mihaigalos/DotControl/hardware/DotControl.brd

## EAGLE design hardware/DotControl.brd (2017-12-18)

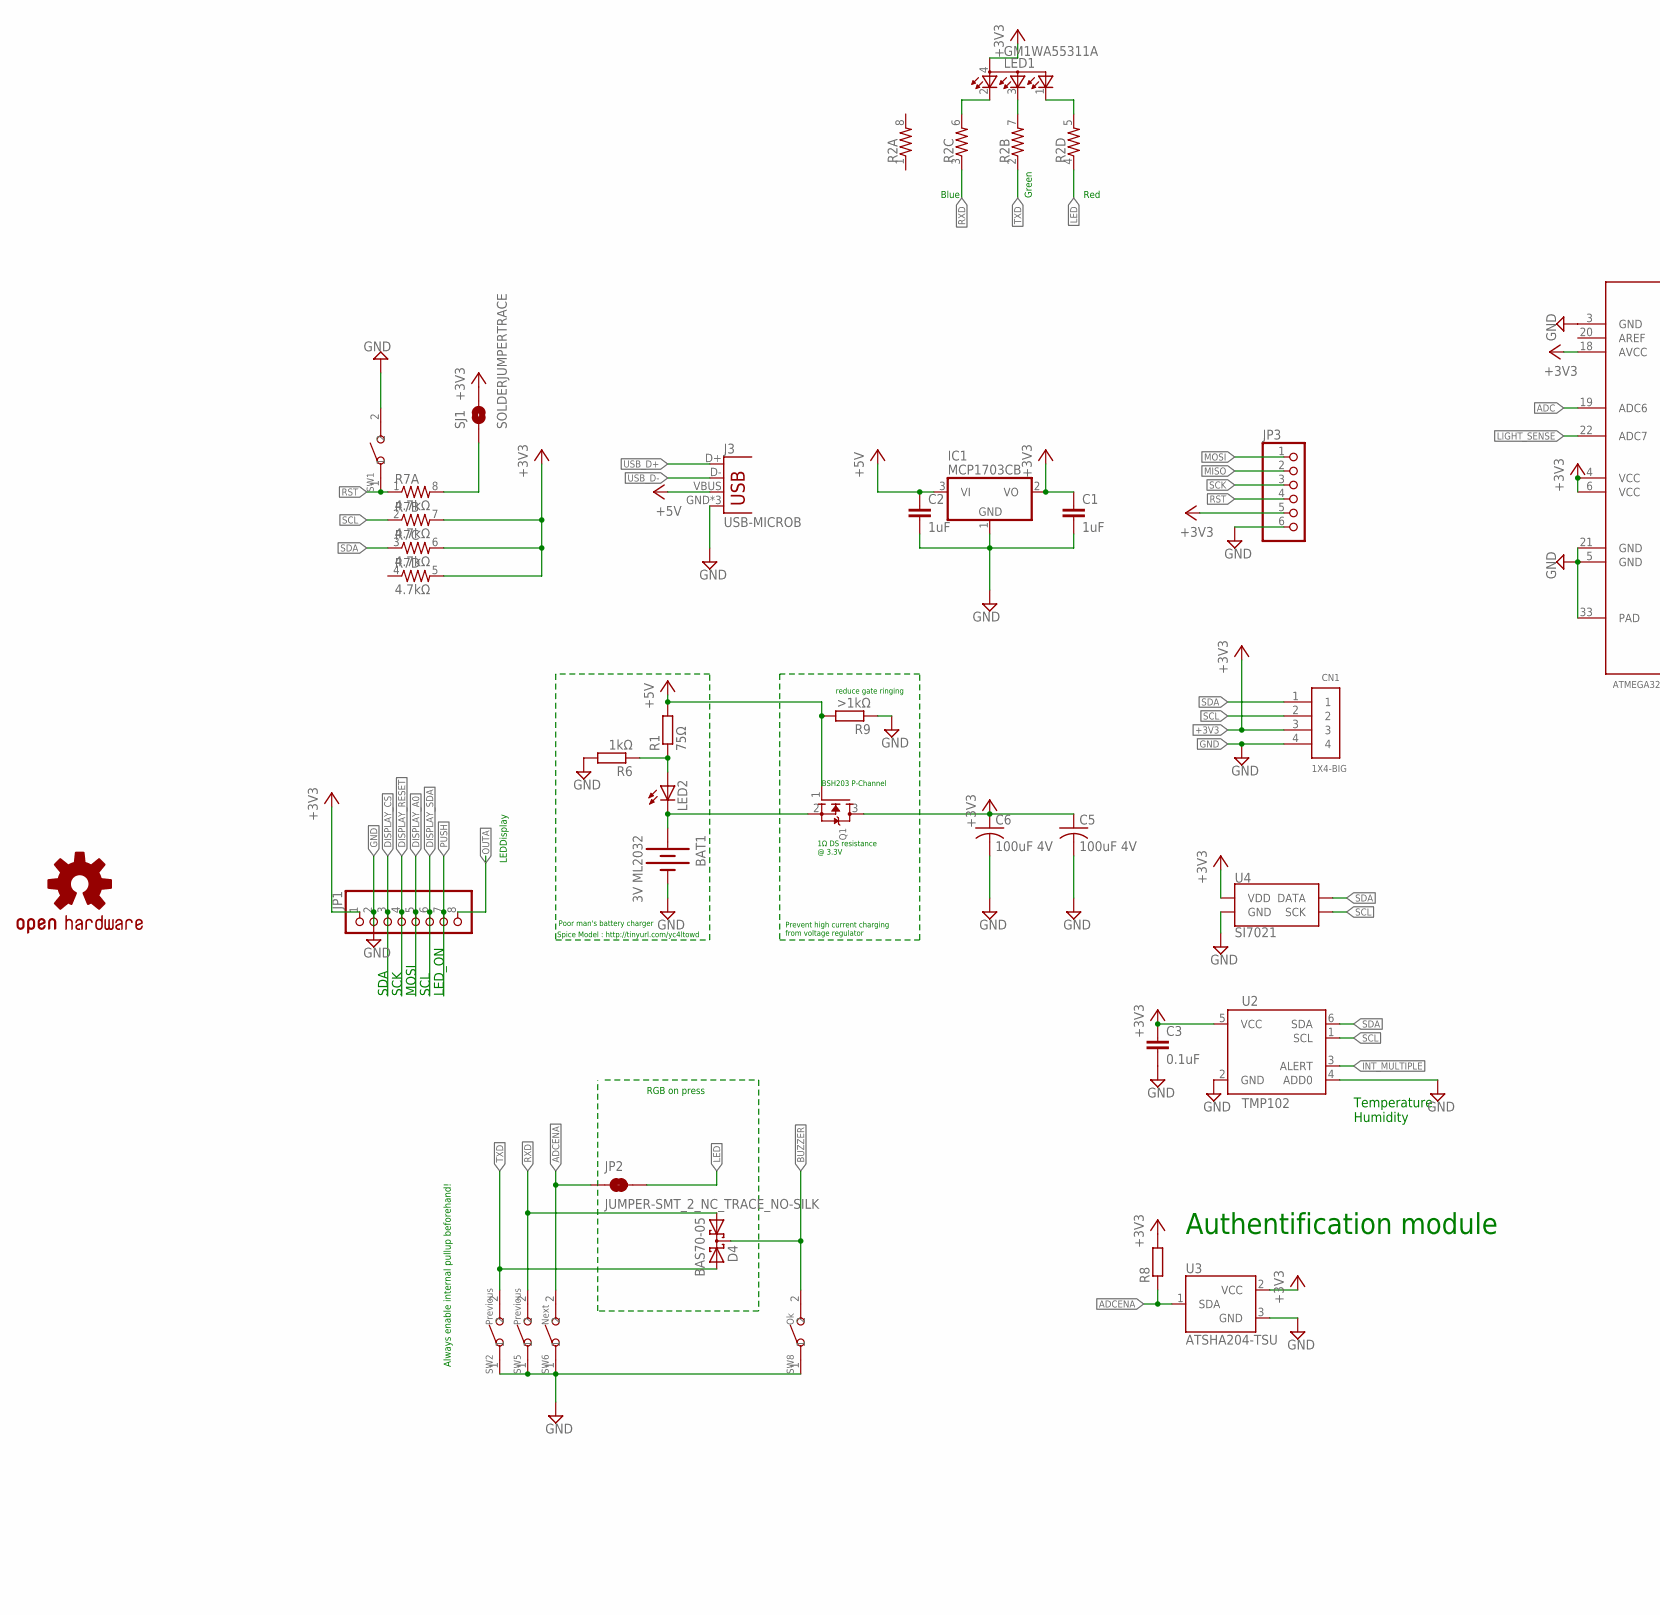
[picture p1: schematic DotControl.sch, sheet 1, part in row 1, column 1]

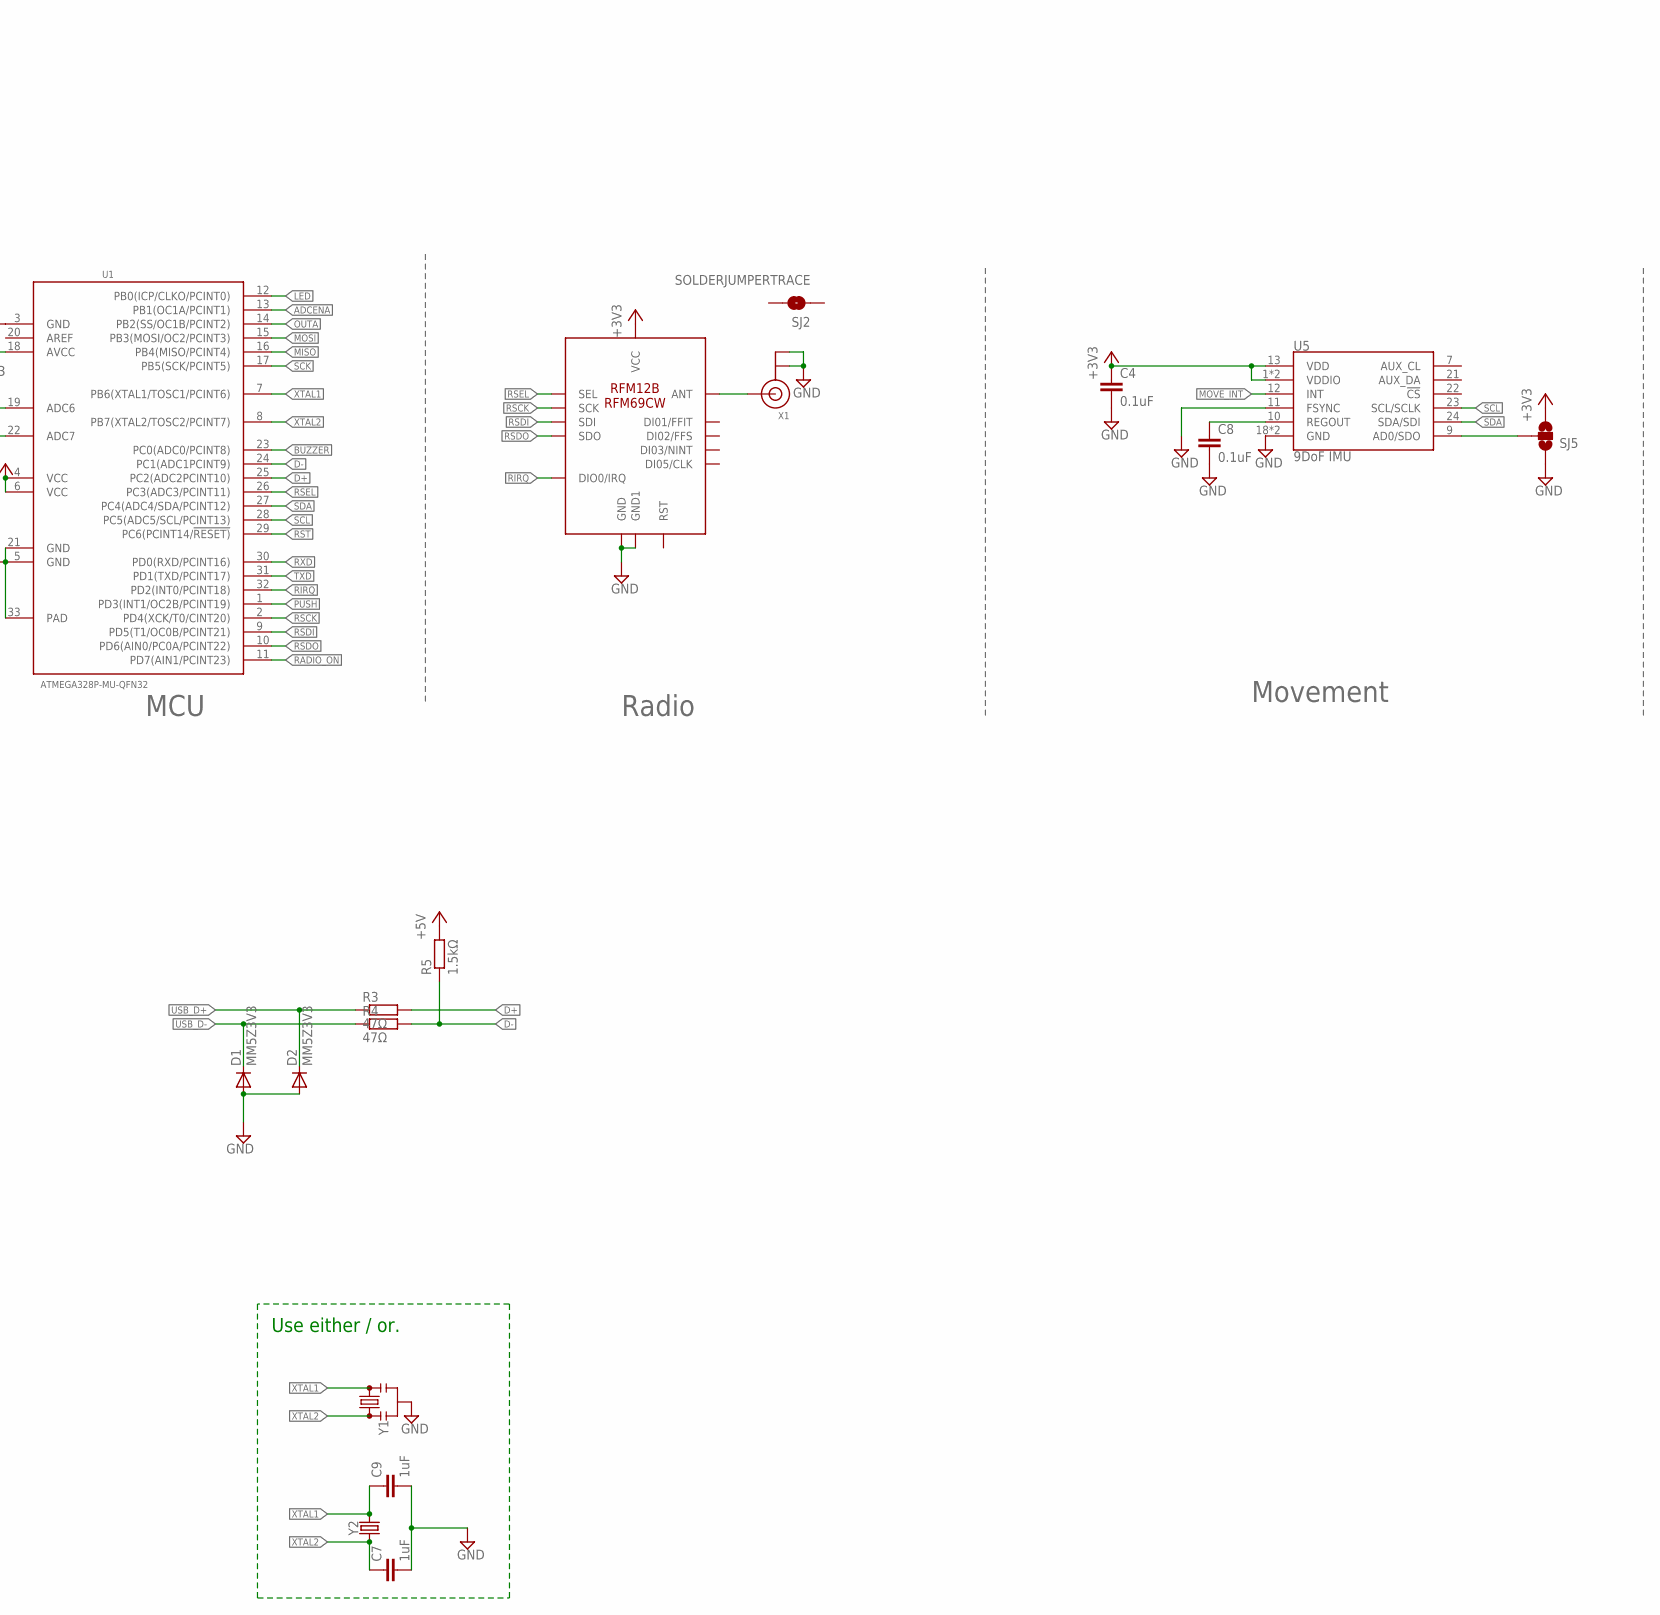
[picture p2: schematic DotControl.sch, sheet 1, part in row 1, column 2]

Parts:
BAT1: 3V ML2032; BATTCOM_20MM_PTH
C1, C2, C7, C9: 1uF; C0603
C3, C4, C8: 0.1uF; C0603
C5, C6: 100uF 4V; C3216
CN1: 1X4-BIG; 1X04-BIG
D1, D2: MM5Z3V3; SOD523
D4: BAS70-05; SOT23
IC1: MCP1703CB; SOT23
J3: USB-MICROB
JP1: PINHD-1X8CLEANBIG; 1X08-CLEANBIG
JP2: JUMPER-SMT_2_NC_TRACE_NO-SILK; SMT-JUMPER_2_NC_TRACE_NO-SILK
JP3: PINHD-1X6; 1X06
LED1: GM1WA55311A
LED2: LED0603; LED-0603
Q1: MOSFET-NREFLOW; SOT23
R1: 75Ω; R0603
R2: RESISTOR-ARRAY0603-ARV; 0603-ARV
R3, R4: 47Ω; R0603
R5: 1.5kΩ; R0603
R6: 1kΩ; R0603
R7: 4.7kΩ; 0603-ARV
R8: R-EU_R0603; R0603
R9: >1kΩ; R0603
SJ1, SJ2: SOLDERJUMPERTRACE; SJ_2S-TRACE
SJ5: SOLDERJUMPER_2WAYS; SJ_3
SW1: SMD-BUTTON(2P-6.0X3.0X2.5MM)-DHT-1163S; SW2-4.0-6.0X3.0X2.5MM
SW2, SW5: Previous; SW2-4.0-6.0X3.0X2.5MM
SW6: Next; SW2-4.0-6.0X3.0X2.5MM
SW8: Ok; SW2-4.0-6.0X3.0X2.5MM
U1: ATMEGA328P-MU-QFN32; QFN32G-0.5-5X5MM
U2: TMP102; SOT563
U3: ATSHA204-TSU; SOT23-3
U4: SI7021; DFN-6-3X3-SI7021
U5: 9DoF IMU; QFN24-3X3
U$1: RFM12B/69CW
U$2: OSHW-LOGOL; OSHW-LOGO-L
X1: ANTENNA_U.FL; U.FL
Y1: RESONATORSMD-3.2X1.3; RESONATOR-SMD-3.2X1.3
Y2: CRYSTALSMD-3.2X1.5; CRYSTAL-SMD-3.2X1.5MM

Connections:
+3V3: C1.1, C3.1, C4.1, C5.1, C6.1, CN1.3, IC1.2 (VO), JP1.1, JP3.5, LED1.4 (A), Q1.3 (D), R7.5 (2), R7.6 (2), R7.7 (2), R8.2, SJ1.2, SJ5.3, U1.4 (VCC), U1.6 (VCC), U1.18 (AVCC), U2.5 (VCC), U3.2 (VCC), U4.VDD, U5.1 (VDDIO), U5.8 (VDDIO), U5.13 (VDD), U$1.VDD (VCC)
+5V: C2.1, IC1.3 (VI), J3.VBUS, Q1.1 (G), R1.2, R5.2, R9.2
ADC: U1.19 (ADC6)
ADCENA: JP2.1, R8.1, SW6.2, U1.13 (PB1(OC1A/PCINT1)), U3.1 (SDA)
BLUE: LED1.2 (CRED), R2.6 (2)
BUZZER: D4.3 (C), SW8.2, U1.23 (PC0(ADC0/PCINT8))
D+: R3.2, U1.25 (PC2(ADC2PCINT10))
D-: R4.2, R5.1, U1.24 (PC1(ADC1PCINT9))
DISPLAY_A0: JP1.5
DISPLAY_CS: JP1.3
DISPLAY_RESET: JP1.4
DISPLAY_SDA: JP1.6
GND: BAT1.2 (-), C1.2, C2.2, C3.2, C4.2, C5.2, C6.2, C7.2, C8.2, C9.2, CN1.4, D1.A, D2.A, IC1.1 (GND), J3.GND, J3.MT1 (GND), J3.MT2 (GND), JP1.2, JP3.6, R6.2, R9.1, SJ5.1, SW1.2, SW2.1, SW5.1, SW6.1, SW8.1, U1.3 (GND), U1.5 (GND), U1.21 (GND), U1.33 (PAD), U2.2 (GND), U2.4 (ADD0), U3.3 (GND), U4.GND, U5.11 (FSYNC), U5.18 (GND), U5.20 (GND), U$1.GND, U$1.GND1, X1.1 (GND), X1.2 (GND), Y1.2
GREEN: LED1.3 (CBLUE), R2.7 (2)
INT_MULTIPLE: U2.3 (ALERT)
LED: JP2.2, R2.4 (1), U1.12 (PB0(ICP/CLKO/PCINT0))
LIGHT_SENSE: U1.22 (ADC7)
MISO: JP3.2, U1.16 (PB4(MISO/PCINT4))
MOSI: JP3.1, U1.15 (PB3(MOSI/OC2/PCINT3))
MOVE_INT: U5.12 (INT)
unnamed: LED2.A, R1.1, R6.1
unnamed: R7.8 (2), SJ1.1
unnamed: U$1.ANT, X1.3 (SIGNAL)
unnamed: SJ5.2, U5.9 (AD0/SDO)
unnamed: C8.1, U5.10 (REGOUT)
unnamed: BAT1.1 (+), LED2.C, Q1.2 (S)
OUTA: JP1.8, U1.14 (PB2(SS/OC1B/PCINT2))
PUSH: JP1.7, U1.1 (PD3(INT1/OC2B/PCINT19))
RADIO_ON: U1.11 (PD7(AIN1/PCINT23))
RED: LED1.1 (CGREEN), R2.5 (2)
RIRQ: U1.32 (PD2(INT0/PCINT18)), U$1.IRQ (DIO0/IRQ)
RSCK: U1.2 (PD4(XCK/T0/CINT20)), U$1.SCK
RSDI: U1.9 (PD5(T1/OC0B/PCINT21)), U$1.SDI
RSDO: U1.10 (PD6(AIN0/PC0A/PCINT22)), U$1.SDO
RSEL: U1.26 (PC3(ADC3/PCINT11)), U$1.SEL
RST: JP3.4, R7.1, SW1.1, U1.29 (PC6(PCINT14/!RESET))
RXD: D4.1 (A1), R2.3 (1), SW5.2, U1.30 (PD0(RXD/PCINT16))
SCK: JP3.3, U1.17 (PB5(SCK/PCINT5))
SCL: CN1.2, R7.2 (1), U1.28 (PC5(ADC5/SCL/PCINT13)), U2.1 (SCL), U4.SCK, U5.23 (SCL/SCLK)
SDA: CN1.1, R7.3 (1), U1.27 (PC4(ADC4/SDA/PCINT12)), U2.6 (SDA), U4.DATA, U5.24 (SDA/SDI)
TXD: D4.2 (A2), R2.2 (1), SW2.2, U1.31 (PD1(TXD/PCINT17))
USB_D+: D2.C, J3.D+, R3.1
USB_D-: D1.C, J3.D-, R4.1
XTAL1: C9.1, U1.7 (PB6(XTAL1/TOSC1/PCINT6)), Y1.3, Y2.P$2 (2)
XTAL2: C7.1, U1.8 (PB7(XTAL2/TOSC2/PCINT7)), Y1.1, Y2.P$1 (1)

Notes on the sheet:
MCU
Radio
Blue
Green
Red
Always enable internal pullup beforehand!
Temperature Humidity
MOSI
SCK
SDA
SCL
LED_ON
LEDDisplay
Authentification module
RGB on press
Movement
Spice Model : http://tinyurl.com/yc4ltowd
BSH203 P-Channel
Poor man's battery charger
Prevent high current charging from voltage regulator
reduce gate ringing
1Ω DS resistance @ 3.3V
Use either / or.

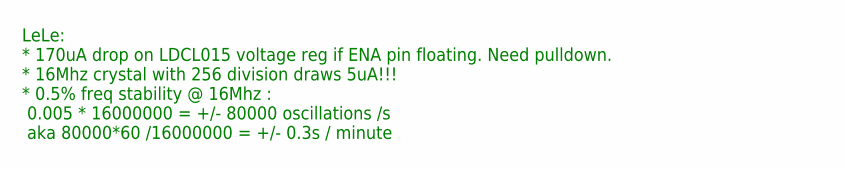
[picture p3: schematic DotControl.sch, sheet 2]

Notes on the sheet:
LeLe: * 170uA drop on LDCL015 voltage reg if ENA pin floating. Need pulldown. * 16Mhz crystal with 256 division draws 5uA!!! * 0.5% freq stability @ 16Mhz : 0.005 * 16000000 = +/- 80000 oscillations /s aka 80000*60 /16000000 = +/- 0.3s / minute

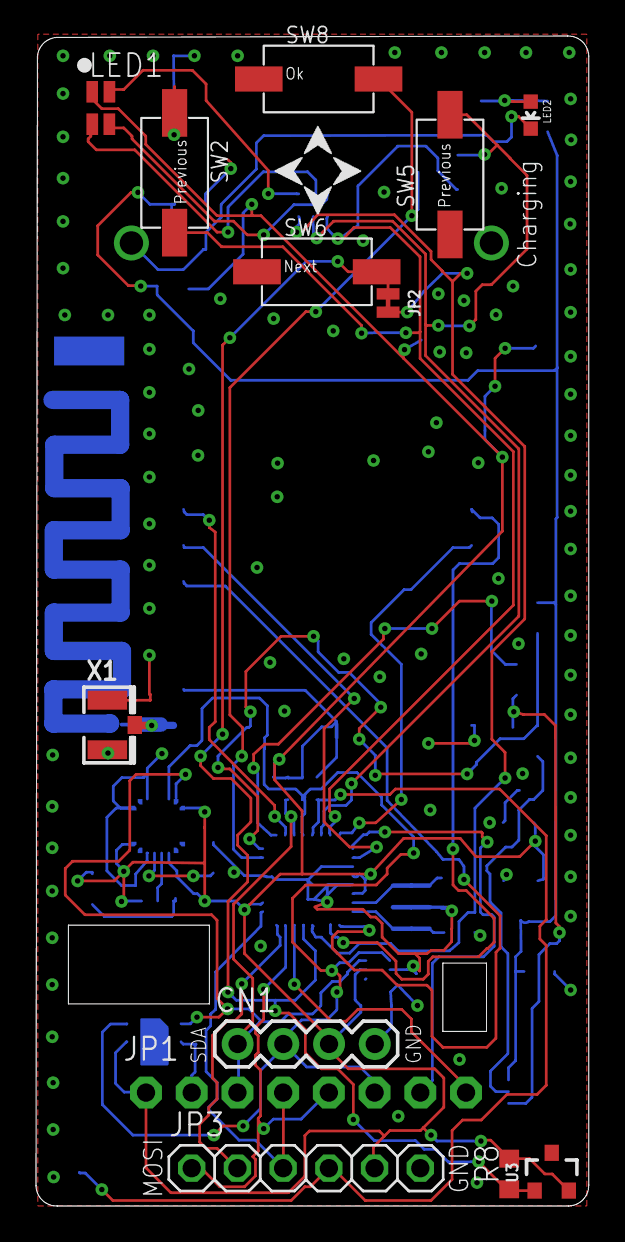
[picture p4: board DotControl.brd from above]

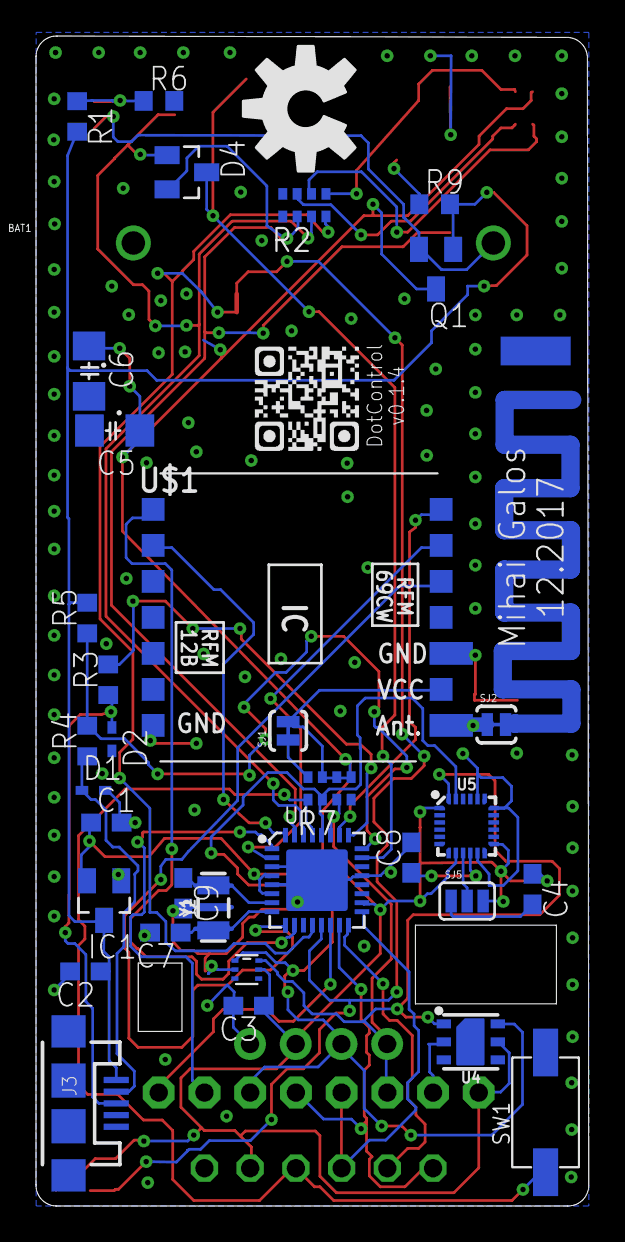
[picture p5: board DotControl.brd from below]

Board: 2 copper layers, 30.7 x 65.0 mm, 49 parts (36 on the bottom side), 36 nets.
