mihaigalos/DotControl/(commit log)

2017-10-31 Initial version
    [DotControl.brd, DotControl.sch]
2017-10-31 Add RGB and crystal
    [DotControl.brd, DotControl.sch]
2017-10-31 Add strong GND plane
    [DotControl.brd]
2017-10-31 Add charging led
    [DotControl.brd, DotControl.sch]
2017-10-31 Add TMP112 temperature sensor
    [DotControl.brd, DotControl.sch]
2017-11-02 Solidify GND plane
    [DotControl.brd]
2017-11-02 Add connections for 128x128
    [DotControl.brd, DotControl.sch]
2017-11-02 Add hardware/ and .gitignore
    [DotControl.brd, DotControl.sch]
2017-11-02 Add QR and timestamp
    [DotControl.brd]
2017-11-03 Update QR rotation
    [DotControl.brd]
2017-11-03 Update display supply to 3.3V, charging of battery
    [DotControl.brd, DotControl.sch]
2017-11-03 Rotate temp sensor
    [DotControl.brd]
2017-11-03 Update version to v0.1.1
    [DotControl.brd]
2017-11-03 Minor rearrange wires
    [DotControl.brd]
2017-11-03 Improve routing and vias
    [DotControl.brd]
2017-11-03 Add rounded corners
    [DotControl.brd]
2017-11-05 Add CryptoAuthentication module
    [DotControl.brd, DotControl.sch]
2017-11-05 Reposition crypto module
    [DotControl.brd]
2017-11-18 Add key to RGB
    [DotControl.brd]
2017-11-18 Add PCB antenna
    [DotControl.brd, DotControl.sch]
2017-11-18 Increase clearance of antenna
    [DotControl.brd]
2017-11-18 Add missing 3V3 connection to battery
    [DotControl.brd, DotControl.sch]
2017-11-18 Improve GND
    [DotControl.brd]
2017-11-18 Edit ToDos
    [DotControl.brd]
2017-11-19 Add HW support for USB bootloading
    [DotControl.brd, DotControl.sch]
2017-11-19 Reassign push buttons
    [DotControl.brd, DotControl.sch]
2017-11-19 Setting vias near rgb R-array further apart
    [DotControl.brd, DotControl.sch]
2017-11-19 Swap R with B @ pushbutton
    [DotControl.brd, DotControl.sch]
2017-11-19 Light RGB composite colors on push press
    [DotControl.brd, DotControl.sch]
2017-11-19 Add Si7021 temp sensor
    [DotControl.brd, DotControl.sch]
2017-11-19 Add I2C text
    [DotControl.brd]
2017-11-20 [Beta] Add HW support for MPU9250
    [DotControl.brd, DotControl.sch]
2017-11-22 Add caps for MPU9250, V divider for battery charge
    [DotControl.brd, DotControl.sch]
2017-11-22 Tidy up logos of Rs
    [DotControl.brd]
2017-11-22 Readjust R values for charger, add Spice link
    [DotControl.brd, DotControl.sch]
2017-11-25 Add pulldown on ENA pin of voltage reg to prefent 150uA quiescent current
    [DotControl.brd, DotControl.sch]
2017-11-25 Add pulldown on ENA pin of voltage reg to prevent 150uA quiescent current
    [DotControl.sch]
2017-11-25 [Intermediate] Improve coincell charging
    [DotControl.brd, DotControl.sch]
2017-11-26 Replace LDO with low quiescence regulator
    [DotControl.brd, DotControl.sch]
2017-11-26 Clean warnings
    [DotControl.brd, DotControl.sch]
2017-11-26 Improve GND, increase version
    [DotControl.brd]
2017-11-26 2x100uF instead of 1x1000uF
    [DotControl.brd, DotControl.sch]
2017-11-26 Update LeLe: 16Mhz with 256 divider = 5uA draw
    [DotControl.brd, DotControl.sch]
2017-11-26 Update LeLe: +/-0.3s / minute drift @ 16Mhz
    [DotControl.sch]
2017-11-30 Add support for 10ppm crystal
    [DotControl.brd, DotControl.sch]
2017-12-06 Add missing pullup to crypto chip
    [DotControl.brd, DotControl.sch]
2017-12-17 Fix info text: BSH103 is N-Channel
    [DotControl.sch]
2017-12-17 Replace BSH103 with BSH203 for charging battery
    [DotControl.sch]
2017-12-18 Fix MOSFET bridge of G-D
    [DotControl.brd]
2017-12-18 Update version to 1.6.3
    [DotControl.brd]
